scavenrage/Daikin-VAM-P1P2-SlaveController/original panel.jpg

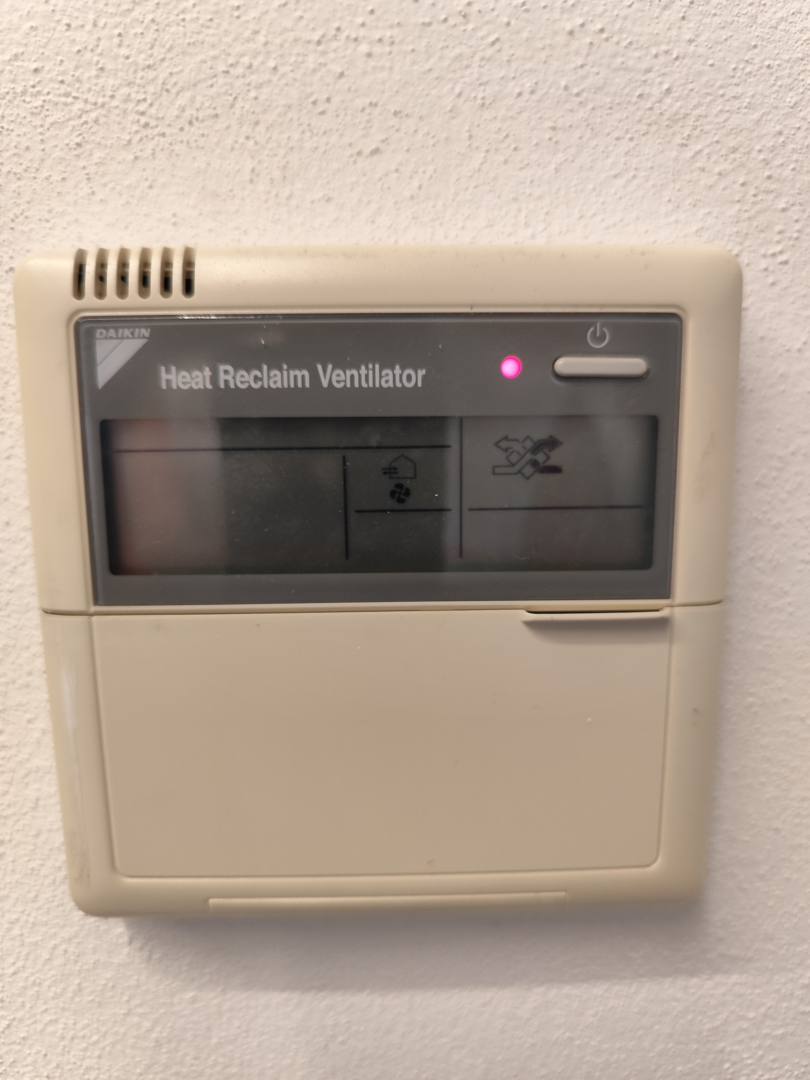
original panel.jpg
