scavenrage/Daikin-VAM-P1P2-SlaveController/pcb intalled.png

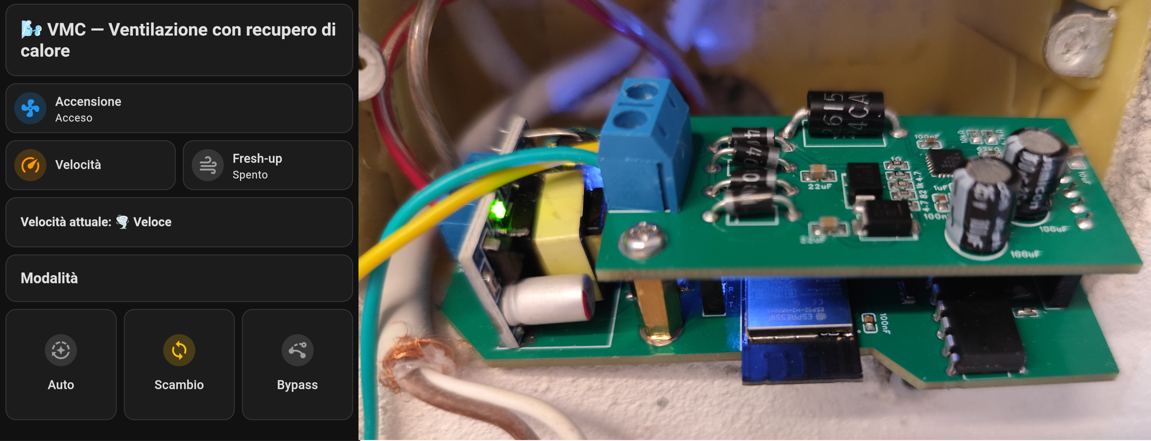
pcb intalled.png
