scavenrage/Daikin-VAM-P1P2-SlaveController/HASS screenshot.png

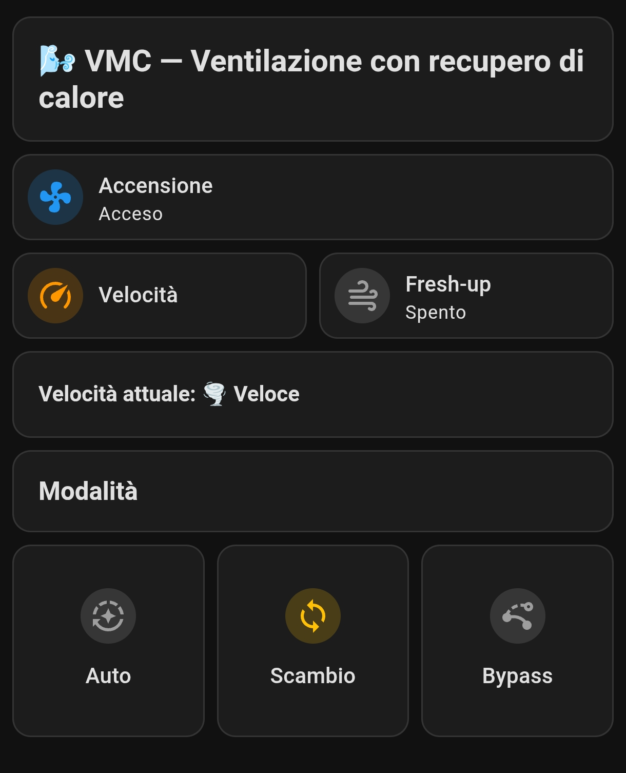
HASS screenshot.png
